ElTschonni/DROBOT-alpha/DROBOT-Client/G-Code/TestJe.txt

G1 X100 Y100 Z1 F1
G1 X8296 Y12619 Z1 F1
G1 X8296 Y16853 Z0 F1
G1 X9884 Y16853 Z0 F1
G1 X9884 Y17377 Z0 F1
G1 X6122 Y17377 Z0 F1
G1 X6122 Y16853 Z0 F1
G1 X7703 Y16853 Z0 F1
G1 X7703 Y12694 Z0 F1
G1 X10591 Y12619 Z1 F1
G1 X14131 Y12619 Z0 F1
G1 X14131 Y13144 Z0 F1
G1 X11184 Y13144 Z0 F1
G1 X11184 Y14820 Z0 F1
G1 X13840 Y14820 Z0 F1
G1 X13840 Y15341 Z0 F1
G1 X11184 Y15341 Z0 F1
G1 X11184 Y16853 Z0 F1
G1 X14020 Y16853 Z0 F1
G1 X14020 Y17377 Z0 F1
G1 X10666 Y17377 Z0 F1
G1 X15024 Y12619 Z1 F1
G1 X15618 Y12619 Z0 F1
G1 X15618 Y14271 Z0 F1
G1 X16427 Y15060 Z0 F1
G1 X18144 Y12619 Z0 F1
G1 X18930 Y12619 Z0 F1
G1 X16842 Y15456 Z0 F1
G1 X18831 Y17377 Z0 F1
G1 X18031 Y17377 Z0 F1
G1 X15618 Y14967 Z0 F1
G1 X15618 Y17377 Z0 F1
G1 X15024 Y17377 Z0 F1
G1 X15024 Y17372 Z0 F1
G1 X19986 Y15558 Z1 F1
G1 X19961 Y15350 Z0 F1
G1 X19943 Y14926 Z0 F1
G1 X19970 Y14550 Z0 F1
G1 X19998 Y14367 Z0 F1
G1 X20045 Y14189 Z0 F1
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
