ElTschonni/DROBOT-alpha/DROBOT-code/src/DR_v02_00.cpp

/*================================================================================
  o   ___          _   _         _   _             .
  -`^'-      o  <_*_>        '\\-//`       '\\-//`        ,-_-|
  (o o)      o  (o o)         (o o)         (o o)        ([o o])
  |--ooO--(_)--Ooo--8---(_)--Ooo-ooO--(_)--Ooo-ooO--(_)--Ooo-ooO--(_)--Ooo- --------|
  |Titel:         Delta Robot Project Teko 2022                                                     
  |File name:     DR_v02_00.cpp                                           
  |Autor Name:    Jonathan Ernst & Reto Bissig  
  |MechanicalTeam: Lorenz, Alain, 
  |Datum:         29.06.2022                                                        
  |Hardware:      M5Stack Core2 (Mikrocontroller: ESP32)                         
  |Software:      Platformio, VS Code                               
  |Beschreibung:  Delta Zeichnungsroboter 

  //Change Log 
2022-06-29_DROBOT_v00.002.ino  - Setup Modbus Server
2022-07-08_DROBOT_v00.007.ino  - I2C Library
2022-07-10_DROBOT_v00.010.cpp -- portation to platformio. - small changes to test I2C library, so far LED on.
2022-07-30_DROBOT_v01.000.cpp -- Setup drawing Random Lines
DR_v02_00.cpp -- Robot can receive new coordinates and draw percize lines

  |---------------------------------------------------------------------------------|
  //=========| include librarys |==================================================*/

#include "m5core2.h"
#include "DROBOT.h"  // Robot controll
#include "Wire.h"    // I2C

#include "WiFi.h"
#include "ModbusIP_ESP8266.h"
#include "WiFiMulti.h"
#include <Adafruit_MCP23X17.h>
#include <Adafruit_PWMServoDriver.h> //
#include "time.h"


//=========| definiere Werte |==================================================*/
#define ON HIGH
#define OFF LOW

#define UP HIGH
#define DOWN LOW

#define OPEN HIGH
#define CLOSE LOW


#define baudRate 2000000  //set baud rate for serial communiction

#define WLAN_SSID "L-TEKO"  // define: suchen und ersetzen im Code "L-TEKO", Wildbachhuis 2.4
#define WLAN_PASSWD "teko2016"     //"teko2016", Milkyway29!
#define MCP23017_ADDR 0x20            //I2C Addrese
#define I2C_Clock_Speed 1700000       // 1.7 MHz
IPAddress ClientIP(192, 168, 40, 68); 
#define Mright 1
#define Mleft 0

#define right_Arm 1
#define left_Arm 0

#define Mright_DIPSW_Value 0b0001  //initial Motor Speed in RPM
#define Mleft_DIPSW_Value 0b0001   //initial Motor Speed in RPM

//Robot Measurements:
#define CoordResolution *100

#define length_BaseToTip_Value 630 CoordResolution  // length from the rotation axis to the tool tip in mm
#define max_TimeForComand_value 60                  //maximum time for one command in s


#define Lenght_UpArm_Value 248 CoordResolution   //length of the  Upper Arm in mm
#define Lenght_LowArm_Value 336 CoordResolution  //length of the  Lower Arm in mm

#define MeetingPoint_TipPoint_Value 67 CoordResolution  //length between tip of the tool and meeting point of arms
#define MeetingPoint_TipPoint_AngleValue 98             //Angle of the line between Meetingpoint to tip of the tool
#define DeltaX_LeftArm_Value 254 CoordResolution        //Delta X from center to rotation point of the Left Arm
#define DeltaX_RightArm_Value 404 CoordResolution       //Delta X from center to rotation point of the Right Arm
#define Transmission_LeftArm_Value 2.5
#define Transmission_RightArm_Value 2.5

#define Coordinate_maxX_Value 600 CoordResolution
#define Coordinate_minX_Value 100 CoordResolution
#define Coordinate_maxY_Value 550 CoordResolution
#define Coordinate_minY_Value 200 CoordResolution

#define Coordinate_0X_Value 140 CoordResolution
#define Coordinate_0Y_Value 242 CoordResolution//-22mm offset 

#define DC_MotorTime_Value 8000  //ms DC Motor Time

//IOPorts //Adresses of Pins for Adafruit MCP23017
#define Mright_Pull_Pin 8     //	GPB0	MCP23017
#define Mright_Dir_Pin 9      //	GPB1	MCP23017
#define Mright_En_Pin 10      //	GPB2	MCP23017
#define Mright_Alarm_Pin 11   //	GPB3	MCP23017
#define Mright_Ped_Pin 12     //	GPB4	MCP23017
#define Limit_Switch_Pin 13   //	GPB5	MCP23017
#define Mvertical_ON_Pin 14   //	GPB6	MCP23017
#define Mvertical_DIR_Pin 15  //	GPB7	MCP23017
#define Clamp_Servo_Pin 0     //	GPA0	MCP23017
#define End_Button2_Pin 1     //	GPA1	MCP23017
#define End_Button1_Pin 2     //	GPA2	MCP23017
#define Mleft_Ped_Pin 3       //	GPA3	MCP23017
#define Mleft_Alarm_Pin 4     //	GPA4	MCP23017
#define Mleft_En_Pin 5        //	GPA5	MCP23017
#define Mleft_Dir_Pin 6       //	GPA6	MCP23017
#define Mleft_Pull_Pin 7      //	GPA7	MCP23017

//Define Servos Clamp
#define SERVOMIN  150 // This is the 'minimum' pulse length count (out of 4096)
#define SERVOMAX  600 // This is the 'maximum' pulse length count (out of 4096)
#define USMIN  600 // This is the rounded 'minimum' microsecond length based on the minimum pulse of 150
#define USMAX  2400 // This is the rounded 'maximum' microsecond length based on the maximum pulse of 600
#define SERVO_FREQ 50 // Analog servos run at ~50 Hz updates

//Sensors:

//Set Constants for modbus
// G01 X30.00 Y100.00 Z10.00 F100
const long BEFEHL_HREG = 0;  // Hreg 0 für den Befehl, z.B. G01
const long X_HREG = 1;       // Hreg 1 für die X-Koordinate
const long Y_HREG = 2;       // Hreg 2 für die Y-Koordinate
const long Z_HREG = 3;       // Hreg 3 für die Z-Koordinate
const long F_HREG = 4;       // Hreg 4 für die Geschwindigkeit
const long STATUS_HREG = 5;  // Hreg 5 für den Zustand der StateMachine


//=========| initializing Classes |==================================================*/
//ModbusIP object
ModbusIP mb;
WiFiMulti wiFiMulti;
Adafruit_MCP23X17 GPIO_Ports_Instanz;                         //creating the MCP23017 Instance
Closed_Loop_Step_Motor Motor_Left_Ins(&GPIO_Ports_Instanz);   //creating the Left Motor Instance
Closed_Loop_Step_Motor Motor_Right_Ins(&GPIO_Ports_Instanz);  //creating the Right Motor Instance
Motor_Movement_Calc MM_Calc_Ins;                              //create the motor movement calculation instance
Delta2D_Kinematic D2D_RightArm_Kin;                           //create the Kinematic Calculation instance
Delta2D_Kinematic D2D_LeftArm_Kin;                            //create the Kinematic Calculation instance
Adafruit_PWMServoDriver pwm_Ports_Instanz = Adafruit_PWMServoDriver(); // called this way, it uses the default address 0x40


//==============================================================================*/
//=========| deklaration von Variabeln |========================================*/
unsigned int programSelector = 6;  //Program selection variable

unsigned int StartUp = 1;
unsigned int LastState = 0;

bool Start_StateMachine = false;
unsigned int Status = 1;  // 1 ready
uint Befehl = 0;

//Timer Variabeln:

struct tm timeinfo;
const char* ntpServer = "0.ch.pool.ntp.org"; //0.ch.pool.ntp.org
const long  gmtOffset_sec = 3600;
const int   daylightOffset_sec = 3600;

unsigned long Timer_Start_01;
unsigned long Timer_Start_02;

unsigned long Timer_Interval_01 = 1000000;
unsigned long Timer_Interval_02 = 10000;

//ModBus

unsigned long X; //X Coordinates
unsigned long Y;
unsigned long Z;
unsigned long F;
unsigned long Alpha;
unsigned long Px, Xaktuell, Xneu;
unsigned long Py, Yaktuell, Yneu;


// Motor Variabeln
int Mright_Speed_Value = 1;  //initial Motor Speed in RPM
int Mleft_Speed_Value = 1;   //initial Motor Speed in RPM

//==============================================================================*/
//=========| Funktionen ModBus |=========================================*/

//Return new GCode_Command ReadModbusRegister CBneuerBefehl

//Return new Client_Command ReadModbusRegister CBneuerBefehl
uint16_t CBneuerBefehl(TRegister* reg, uint16_t val) {
  if (Start_StateMachine == false) {
    Serial.println("Neuer Befehl!");
    programSelector = 2;
    Befehl = mb.Hreg(BEFEHL_HREG);
    Start_StateMachine = true;
    LastState = 0;
  }
  return val;
}

uint16_t CBneuerParameterX(TRegister* reg, uint16_t val) {
  Serial.println("Neue Parameter X!");
  X = (mb.Hreg(X_HREG)) + (Coordinate_0X_Value);  // X in 100stel Millimeter
  LastState = 0;
  return val;
}
uint16_t CBneuerParameterY(TRegister* reg, uint16_t val) {
  Serial.println("Neue Parameter Y!");
  Y = (mb.Hreg(Y_HREG)) + (Coordinate_0Y_Value);
  LastState = 0;
  return val;
}
uint16_t CBneuerParameterZ(TRegister* reg, uint16_t val) {
  Serial.println("Neue Parameter Z!");
  Z = mb.Hreg(Z_HREG);

  LastState = 0;
  return val;
}
uint16_t CBneuerParameterF(TRegister* reg, uint16_t val) {
  Serial.println("Neue Parameter F!");
  F = mb.Hreg(F_HREG);  // Geschwindigkeit in mm/min
  LastState = 0;
  return val;
}



//=========| Funktionen Program |=========================================*/
void moveToNewPositionLeft() {
  unsigned long counterTollerance = 0;
  bool exitStep = false;

  do {
    //   Serial.print(" Number of Steps: ");
    //   Serial.print(counterTollerance++);

    do {  //do one step
      if (Motor_Left_Ins.OneStepDir() == 0) exitStep = false;
      else { exitStep = true; }
      if (Motor_Left_Ins.errorcode > 0) exitStep = true;
    } while (exitStep == false);

  } while (!Motor_Left_Ins.Angle_Tollerance_Value);

  counterTollerance = 0;
}

void moveToNewPositionRight() {
  unsigned long counterTollerance = 0;
  bool exitStep = false;

  do {
    //   Serial.print(" Number of Steps: ");
    //   Serial.print(counterTollerance++);

    do {  //do one step
      if (Motor_Right_Ins.OneStepDir() == 0) exitStep = false;
      else { exitStep = true; }
      if (Motor_Right_Ins.errorcode > 0) exitStep = true;
    } while (exitStep == false);

  } while (!Motor_Right_Ins.Angle_Tollerance_Value);

  counterTollerance = 0;
}

void moveToNewPosition() {
  unsigned long counterTollerance = 0;
  //unsigned long counter = 0;
  //double TotalTimeL = 0;
  // double TotalTimeR = 0;

  bool exitStep = false;


  do {
    //   Serial.print(" Number of Steps: ");
    counterTollerance++;
    /* Motor_Left_Ins.StartTimer();
  Motor_Right_Ins.StartTimer();*/

    do {  //do one step

      if (Motor_Right_Ins.OneStepDir() == 0) exitStep = false;
      else { exitStep = true; }
      if (Motor_Right_Ins.errorcode > 0) exitStep = true;

    } while (exitStep == false);
    do {  //do one step

      if (Motor_Left_Ins.OneStepDir() == 0) exitStep = false;
      else { exitStep = true; }
      if (Motor_Left_Ins.errorcode > 0) exitStep = true;
    } while (exitStep == false);
    /*counter++;
TotalTimeL= TotalTimeL + Motor_Left_Ins.TimeControll();*/
    //TotalTimeR= TotalTimeR + Motor_Right_Ins.TimeControll();


  } while (!Motor_Right_Ins.Angle_Tollerance_Value or !Motor_Left_Ins.Angle_Tollerance_Value);
  /*  Serial.println("");
  Serial.print("mTNP: Step Time L: ");
  Serial.println(TotalTimeL/counter);
  Serial.print(" R: ");
  Serial.println(TotalTimeR/counter);
  counter=0;*/

  Serial.println("mTNP: Both Angle in Tollerance: ");
  Motor_Left_Ins.setNewAngelValue(Motor_Left_Ins.getOldAngelValue());
  Motor_Right_Ins.setNewAngelValue(Motor_Right_Ins.getOldAngelValue());

  counterTollerance = 0;
}

//Z-Axis
bool controllZAxis(bool dir_DCMotor_val, unsigned long RunTime) {
  unsigned long startTime = 0;

  Serial.print("ZAX: End Button: ");
  Serial.println(GPIO_Ports_Instanz.digitalRead(Limit_Switch_Pin));

  if (dir_DCMotor_val and GPIO_Ports_Instanz.digitalRead(Limit_Switch_Pin))  //hoch
  {
  Serial.println("ZAX: UP: ");
  Serial.print("ZAX: Button: ");  
   Serial.println(GPIO_Ports_Instanz.digitalRead(Limit_Switch_Pin));
  Serial.print("ZAX: dir_DCMotor_val: ");
  Serial.println(dir_DCMotor_val);
  
    GPIO_Ports_Instanz.digitalWrite((Mvertical_DIR_Pin), HIGH);
    GPIO_Ports_Instanz.digitalWrite(Mvertical_ON_Pin, HIGH);

    do {  
    } while (GPIO_Ports_Instanz.digitalRead(Limit_Switch_Pin));
       GPIO_Ports_Instanz.digitalWrite(Mvertical_ON_Pin, LOW);

  } else if (!dir_DCMotor_val and !GPIO_Ports_Instanz.digitalRead(Limit_Switch_Pin))  //runter
  {
  Serial.println("ZAX: DOWN: ");
   Serial.print("ZAX: Button: ");  
   Serial.println(GPIO_Ports_Instanz.digitalRead(Limit_Switch_Pin));
  Serial.print("ZAX: dir_DCMotor_val: ");
  Serial.println(dir_DCMotor_val);

    GPIO_Ports_Instanz.digitalWrite((Mvertical_DIR_Pin), LOW);
    GPIO_Ports_Instanz.digitalWrite(Mvertical_ON_Pin, HIGH);  //Motor Ein
    startTime = millis();

    do {
    } while ((millis() - startTime < RunTime));
    GPIO_Ports_Instanz.digitalWrite(Mvertical_ON_Pin, LOW);  //Motor Aus
  } else {
    return (1);
  };

  return (1);
}


//Clamp
bool controllClamp(bool dir_clamp_value)//close: 0 open : 1
{uint16_t pulselength = 0;
  //close clamp
  if (!dir_clamp_value){
 for (pulselength = SERVOMIN; pulselength < SERVOMAX; pulselength++) {
    pwm_Ports_Instanz.setPWM(0, 0, pulselength);
    pwm_Ports_Instanz.setPWM(1, 0, pulselength);
    pwm_Ports_Instanz.setPWM(2, 0, pulselength);
  }
  pwm_Ports_Instanz.setPWM(0, 0, SERVOMAX);

}  //open clamp
  if (dir_clamp_value){
  for (pulselength = SERVOMAX; pulselength > SERVOMIN; pulselength--) {
    pwm_Ports_Instanz.setPWM(0, 0, pulselength);
    pwm_Ports_Instanz.setPWM(1, 0, pulselength);
    pwm_Ports_Instanz.setPWM(2, 0, pulselength);

   }
   pwm_Ports_Instanz.setPWM(0, 0, SERVOMIN);
   }
     return (1);
}

//Wifi Check
void checkWiFiConnection() { 
 

 if(!getLocalTime(&timeinfo)){
  Serial.println("Failed to obtain time");
     if (WiFi.status() == WL_CONNECTED) {
    }
    else{
    delay(350);
    Serial.println("Wifi Not Connected");
    WiFi.disconnect(); 

    wiFiMulti.addAP(WLAN_SSID, WLAN_PASSWD);
  long sum = 0;

  while (wiFiMulti.run() != WL_CONNECTED) {
    Serial.print(".");
    M5.lcd.print(".");
    sum += 1;
    if (sum == 8) {
      Serial.println("!Connect: Failed!");
      M5.lcd.print("!Connect: Failed!");
      wiFiMulti.addAP(WLAN_SSID, WLAN_PASSWD);
    }
  }
}
  }
  
  
}

//=========| Funktionen StateMachine |=========================================*/



unsigned int Standby()  //State 1
{
       
  //mb.Hreg(STATUS_HREG, Status);
  //  mb.Hreg(STATUS_HREG, 4);

 delay(1000);
  M5.Lcd.fillRect(10,40,240,20,GREEN);
    M5.Lcd.setCursor(10, 40);
   getLocalTime(&timeinfo);
    M5.lcd.print(&timeinfo);
 delay(1000);
  M5.Lcd.fillRect(10,40,240,20,GREEN);
    M5.Lcd.setCursor(10, 40);
   getLocalTime(&timeinfo);
    M5.lcd.print(&timeinfo);

  if (LastState != 1) {//set Robot Status to 1 and send this info to client
    Status = 1;
    mb.Hreg(STATUS_HREG, Status);

    Start_StateMachine = false;
    M5.Lcd.fillScreen(GREEN);
  M5.Lcd.setTextSize(3);
  M5.Lcd.setCursor(10, 10);
  M5.Lcd.setTextColor(BLACK);

    Serial.print("- Standby: ");
    M5.lcd.println("Standby");
    M5.Lcd.setCursor(10, 60);
      M5.Lcd.setTextColor(NAVY);
       M5.Lcd.setTextSize(2);
  Serial.print("IP: ");
  Serial.println(WiFi.localIP());
 M5.Lcd.print("IP: ");
 M5.Lcd.println(WiFi.localIP());

    //programSelector = 1;

    Serial.print(STATUS_HREG);
    Serial.print(Status);
    Serial.print("- Roboter_State: ");
    Serial.print(Status);
    Serial.print(" GCode_Command: ");
    Serial.print(Befehl);
    Serial.print(" Start Statemachine: ");
    Serial.println(Start_StateMachine);
  }

  //GPIO_Ports_Instanz.digitalWrite(Clamp_Servo_Pin, HIGH);
     M5.Lcd.setTextColor(NAVY);
     M5.Lcd.fillRect(6,210,100,30,DARKGREEN);
     M5.Lcd.setCursor(16,220);
    M5.Lcd.print("CLOSE");

M5.Lcd.fillRect(109,210,100,30,DARKGREEN);
    M5.Lcd.setCursor(119, 220);
    M5.Lcd.print("OPEN");

M5.Lcd.fillRect(212,210,100,30,DARKGREEN);
    M5.Lcd.setCursor(225, 220);
    M5.Lcd.print("HOME");

 if (M5.BtnA.wasReleased() || M5.BtnA.pressedFor(1000, 200)) {
       M5.Lcd.setTextColor(NAVY);
     M5.Lcd.fillRect(6,210,100,30,GREENYELLOW);
     M5.Lcd.setCursor(16,220);
    M5.Lcd.print("CLOSING");
   Serial.println(" S1: Closing Clamp ");
      controllClamp(CLOSE);
      delay(1000);

  } else if (M5.BtnB.wasReleased() || M5.BtnB.pressedFor(1000, 200)) {
     M5.Lcd.fillRect(109,210,100,30,GREENYELLOW);
    M5.Lcd.setCursor(119, 220);
    M5.Lcd.print("OPENING");
   Serial.println(" S1: OPENING Clamp ");
      controllClamp(OPEN);
            delay(1000);

  } else if (M5.BtnC.wasReleased() || M5.BtnC.pressedFor(1000, 200)) {
M5.Lcd.fillRect(212,210,100,30,DARKGREEN);
    M5.Lcd.setCursor(225, 220);
    M5.Lcd.print("HOMING");
   Serial.println(" S1: homing ");
   programSelector =7;

    delay(1000);
  }   
      
  LastState = 1;
  return (programSelector);
}

unsigned int Receive()  //State 2 Verarbeitung
{M5.Lcd.fillScreen(GREENYELLOW);
  Serial.println("------ State Receive------");
  Serial.print("- Roboter_State: ");
  Serial.println(Status);
  Serial.print("- GCode_Command: ");
  Serial.println(Befehl);
  Serial.print("- Start Statemachine: ");
  Serial.println(Start_StateMachine);


  if (Status == 1 and Start_StateMachine) {
    Serial.println("- StateMachine: Started");

    if (Befehl == 0 or Befehl == 1) {
      Serial.println("- Receive: Data");
      Serial.print(" G");
      Serial.print(Befehl);
      Serial.print(" X");
      Serial.print(X);
      Serial.print(" Y");
      Serial.print(Y);
      Serial.print(" Z");
      Serial.print(Z);
      Serial.print(" F");
      Serial.println(F);

      MM_Calc_Ins.setTargetCoordinates(X, Y);

      MM_Calc_Ins.Done_Steps_Value = 0;
 LastState = 2;
      Status = 2;  // gehe zu draw

        M5.Lcd.fillScreen(NAVY);
      return (3);

      /*

      if(X>(Coordinate_maxX_Value)){
           Serial.println("Warning: X Coordinates above <Radius of Action>");
      Status = 3;  // gehe zu draw
      return (5);
      }
      if(X<(Coordinate_minX_Value)){
         Serial.println("Warning: X Coordinates below <Radius of Action>");
      Status = 3;  // gehe zu draw
      return (5);
      }
            if(Y>(Coordinate_maxY_Value)){
               Serial.println("Warning: Y Coordinates above <Radius of Action>");
      Status = 3;  // gehe zu draw
      return (5);
      }
            if(Y<(Coordinate_minY_Value)){
               Serial.println("Warning: Y Coordinates below <Radius of Action>");
      Status = 3;  // gehe zu draw
      return (5);
      }

*/

    } else {
      Status = 3;  // falscher Befehl
       LastState = 2;
      return (4);
    }
  }

  /*
  if (Timer_Start_01 + Timer_Interval_01 < micros()) {
    Timer_Start_01 = micros();
    Timer_Interval_01 = 1000000;
  }*/
 
}

unsigned int Draw() {  //State 3
Status = 2;
  mb.Hreg(STATUS_HREG, Status);
   mb.Hreg(STATUS_HREG, Status);


    Serial.println("S3: Draw");
     Serial.print("S3: Roboter Status: ");
      Serial.print(Status);

    M5.Lcd.setTextSize(3);
  M5.Lcd.setCursor(10, 10);
  M5.Lcd.setTextColor(ORANGE);
  M5.lcd.println("DRAW");
  M5.Lcd.setTextSize(2);
  M5.Lcd.fillRect(10,40,240,20,NAVY);
    M5.Lcd.setCursor(10,40);

   getLocalTime(&timeinfo);
      M5.lcd.print(&timeinfo);

        M5.Lcd.fillRect(10,60,280,20,NAVY);
  M5.Lcd.setCursor(10, 60);
  M5.Lcd.setTextColor(GREENYELLOW);
    M5.lcd.print("o>X "); 
    M5.Lcd.setTextColor(YELLOW);
    M5.Lcd.drawFloat(MM_Calc_Ins.X1_Origin_Value, 0, 50, 60);
     // M5.lcd.print(MM_Calc_Ins.Xz_NextStep_Value);
       M5.Lcd.setCursor(150, 60);
      M5.Lcd.setTextColor(GREENYELLOW);
        M5.lcd.print("o>TY ");
        M5.Lcd.setTextColor(YELLOW);
        M5.Lcd.drawFloat(MM_Calc_Ins.Y1_Origin_Value, 0, 200,60);
        //  M5.lcd.println(MM_Calc_Ins.Yz_NextStep_Value);
  
  M5.Lcd.fillRect(10,80,280,20,NAVY);
  M5.Lcd.setCursor(10, 80);
  M5.Lcd.setTextColor(GREENYELLOW);
    M5.lcd.print("o X "); 
    M5.Lcd.setTextColor(YELLOW);
    M5.Lcd.drawFloat(MM_Calc_Ins.Xz_NextStep_Value, 0, 50,80);
     // M5.lcd.print(MM_Calc_Ins.Xz_NextStep_Value);
       M5.Lcd.setCursor(150, 80);
      M5.Lcd.setTextColor(GREENYELLOW);
        M5.lcd.print("o Y ");
        M5.Lcd.setTextColor(YELLOW);
        M5.Lcd.drawFloat(MM_Calc_Ins.Yz_NextStep_Value, 0, 200,80);
        //  M5.lcd.println(MM_Calc_Ins.Yz_NextStep_Value);

  M5.Lcd.fillRect(10,100,280,20,NAVY);
  M5.Lcd.setCursor(10, 100);
  M5.Lcd.setTextColor(GREENYELLOW);
    M5.lcd.print(">oX "); 
    M5.Lcd.setTextColor(YELLOW);
    M5.Lcd.drawFloat(MM_Calc_Ins.X2_Target_Value, 0, 50, 100);
     // M5.lcd.print(MM_Calc_Ins.Xz_NextStep_Value);
       M5.Lcd.setCursor(150, 100);
      M5.Lcd.setTextColor(GREENYELLOW);
        M5.lcd.print(">oTY ");
        M5.Lcd.setTextColor(YELLOW);
        M5.Lcd.drawFloat(MM_Calc_Ins.Y2_Target_Value, 0, 200,100);
        //  M5.lcd.println(MM_Calc_Ins.Yz_NextStep_Value);
    
    M5.Lcd.fillRect(10,120,240,20,NAVY);
   M5.Lcd.setCursor(10, 120);
  M5.Lcd.setTextColor(GREENYELLOW);
    M5.lcd.print("alphaL: "); 
    M5.Lcd.setTextColor(YELLOW);
       M5.Lcd.drawFloat(Motor_Left_Ins.getNewAngelValue(), 2, 100,120);
     // M5.lcd.println(Motor_Left_Ins.getNewAngelValue());
     
    M5.Lcd.fillRect(10,140,240,20,NAVY);
     M5.Lcd.setCursor(10, 140);
          M5.Lcd.setTextColor(GREENYELLOW);
        M5.lcd.print("alphaR: ");
        M5.Lcd.setTextColor(YELLOW);
          M5.Lcd.drawFloat(Motor_Right_Ins.getNewAngelValue(), 2, 100,140);
        //  M5.lcd.println(Motor_Right_Ins.getNewAngelValue());
    M5.Lcd.fillRect(10,160,240,20,NAVY);
     M5.Lcd.setCursor(10,160);
  M5.Lcd.setTextColor(GREENYELLOW);
    M5.lcd.print("Progress: "); M5.Lcd.setTextColor(YELLOW);
  M5.Lcd.drawFloat((MM_Calc_Ins.Done_Steps_Value*1.00/(MM_Calc_Ins.TotalNof_Steps_Value*1.00+1.00))*100.00, 2, 120,160);
     // M5.lcd.print((MM_Calc_Ins.Done_Steps_Value*1.00/(MM_Calc_Ins.TotalNof_Steps_Value*1.00+1.00))*100.00 );
      M5.Lcd.setTextColor(GREENYELLOW);
       M5.Lcd.setCursor(200, 160);
        M5.lcd.println("% ");M5.Lcd.setTextColor(YELLOW);

  double old_Angle_value = 0;
  double new_Angle_value = 0;
  unsigned long determinant_RightArm_Value = 0;
  unsigned long determinant_LeftArm_Value = 0;


if (Z>0){
  Serial.print(" S3: DC Motor Up: ");

  do { } while (!controllZAxis(UP, DC_MotorTime_Value));
}
if (Z==0){
  Serial.print(" S3: DC Motor Down: ");

  do { } while (!controllZAxis(DOWN, DC_MotorTime_Value));
}


  //delay(500);
  //1.Step: LED Blink,
  //Motor_Left_Ins.test();  //Motor Class Test

  //2.Step:  set new target coordinates and start the interpolation:

  MM_Calc_Ins.Interpolate();

  //3.Step: Calculate new Angle to reach thos coordinates.
  //Right arm first //Calculation with Tool Offset
  determinant_RightArm_Value = D2D_RightArm_Kin.IntersectionOfTwoCircles(DeltaX_RightArm_Value, 0, MM_Calc_Ins.Xz_NextStep_Value, MM_Calc_Ins.Yz_NextStep_Value);
  if (determinant_RightArm_Value == 2) {
    D2D_RightArm_Kin.InverseKinematic(right_Arm);
  }

  else {
    Serial.print("S3: Kinematic Error Right:  ");
    Serial.println(determinant_RightArm_Value);
  }

//calculate coordinates for the second arm Left
D2D_RightArm_Kin.RecalcCoordinates(MM_Calc_Ins.Xz_NextStep_Value,MM_Calc_Ins.Yz_NextStep_Value);


  //Left Arm
  determinant_LeftArm_Value = D2D_LeftArm_Kin.IntersectionOfTwoCircles(DeltaX_LeftArm_Value, 0, D2D_RightArm_Kin.Xz_newRightArm_Value, D2D_RightArm_Kin.Yz_newRightArm_Value);
  if (determinant_LeftArm_Value == 2) {
    D2D_LeftArm_Kin.InverseKinematic(left_Arm);
  }

  else {
    Serial.print("S3: Kinematic Error Left:  ");
    Serial.println(determinant_LeftArm_Value);
  }

//Step 3.1 Calculate other coordinates

  //4.Step:  set new angle

  if (Motor_Left_Ins.setNewAngelValue(D2D_LeftArm_Kin.angle_LeftArm_Value2)) Serial.println("S3:  Motor Left Set Angle: Succeed");
  else {
    Serial.println("S3: Motor Left Set Angle: Failed");
    return (5);
  }

  if (Motor_Right_Ins.setNewAngelValue(D2D_RightArm_Kin.angle_RightArm_Value1)) Serial.println("S3:  Motor Right Set Angle: Succeed");
  else {
    Serial.println("S3: Motor Right Set Angle: Failed");
    return (5);
  }

  //5.Step: move from old angle to new angle
  /*
moveToNewPositionLeft();
moveToNewPositionRight();
*/
  moveToNewPosition();

  //6.Step: exit conditions:
  Start_StateMachine = false;

  //delay(3000);
  //7.Step: if there was an error, go to State 3 Error
  if (Motor_Left_Ins.errorcode > 0) {
    //Status = 3;
    return (5);
  }
  //8.Step: if the current coordinates are not equal to the target coordinates do the loop again
  else if ((MM_Calc_Ins.Xz_NextStep_Value < MM_Calc_Ins.X2_Target_Value) and (MM_Calc_Ins.Yz_NextStep_Value < MM_Calc_Ins.Y2_Target_Value)) {


    if ((MM_Calc_Ins.Xz_NextStep_Value == 0) or (MM_Calc_Ins.Yz_NextStep_Value == 0)) {
     // Status = 3;
      LastState = 3;
      return (5);
    } else {
      //Status = 2;
      LastState = 3;
      return (3);
    }

  } else if ((MM_Calc_Ins.Xz_NextStep_Value == MM_Calc_Ins.X2_Target_Value) and (MM_Calc_Ins.Yz_NextStep_Value == MM_Calc_Ins.Y2_Target_Value)) {
    //9.Step: if the Target Coordinates are equal to the current coordinates, go to state 1
    Serial.print("S3: New Coordinates have been reached: Xz ");
    Serial.print(MM_Calc_Ins.Xz_NextStep_Value);
    Serial.print("Yz ");
    Serial.print(MM_Calc_Ins.Yz_NextStep_Value);
    Serial.print(" / X2 ");
    Serial.print(MM_Calc_Ins.X2_Target_Value);
    Serial.print(" / Y2 ");
    Serial.println(MM_Calc_Ins.Y2_Target_Value);
    Serial.print("S3:  Waiting for new Coordinates ");

    MM_Calc_Ins.setOriginCoordinates(MM_Calc_Ins.X2_Target_Value, MM_Calc_Ins.Y2_Target_Value);

  
    LastState = 3;
    return (1);
  } else {

    if (MM_Calc_Ins.Done_Steps_Value < MM_Calc_Ins.TotalNof_Steps_Value) {

      Serial.print("S3: Coordinates and Angle Match -> go to next Interpolate Step. ");


      LastState = 3;
      return (3);
    } else if (MM_Calc_Ins.Done_Steps_Value == MM_Calc_Ins.TotalNof_Steps_Value) { //Ziel Koordinaten wurden erreicht

      Serial.print("S3: Interpolate Steps Finished: Xz ");
      Serial.print(MM_Calc_Ins.Xz_NextStep_Value);
      Serial.print("Yz ");
      Serial.print(MM_Calc_Ins.Yz_NextStep_Value);
      Serial.print(" / X2 ");
      Serial.print(MM_Calc_Ins.X2_Target_Value);
      Serial.print(" / Y2 ");
      Serial.println(MM_Calc_Ins.Y2_Target_Value);
      Serial.print("S3:  Waiting for new Coordinates ");

      MM_Calc_Ins.setOriginCoordinates(MM_Calc_Ins.X2_Target_Value, MM_Calc_Ins.Y2_Target_Value);


      LastState = 3;
      return (1);
    } else {
      Serial.println("S3: Error Case ");  //error case print data

      Serial.print("S3: Origin:   X1: ");
      Serial.print(MM_Calc_Ins.X1_Origin_Value);
      Serial.print(" Y1: ");
      Serial.println(MM_Calc_Ins.Y1_Origin_Value);

      Serial.print("S3: NextStep: Xz: ");
      Serial.print(MM_Calc_Ins.Xz_NextStep_Value);
      Serial.print(" Yz: ");
      Serial.println(MM_Calc_Ins.Yz_NextStep_Value);

      Serial.print("S3: Target:    X2: ");
      Serial.print(MM_Calc_Ins.X2_Target_Value);
      Serial.print(" Y2: ");
      Serial.println(MM_Calc_Ins.Y2_Target_Value);

      Serial.print("S3: OldAngle: L°: ");
      Serial.print(Motor_Left_Ins.getOldAngelValue());
      Serial.print(" R°: ");
      Serial.println(Motor_Right_Ins.getOldAngelValue());

      Serial.print("S3: NewAngle: L°: ");
      Serial.print(Motor_Left_Ins.getNewAngelValue());
      Serial.print(" R°: ");
      Serial.println(Motor_Right_Ins.getNewAngelValue());

      Serial.print("S3: MinResol:  L: ");
      Serial.print(MM_Calc_Ins.Min_Resolution_Value);
      Serial.print(" Max°: ");
      Serial.print(Motor_Left_Ins.Max_AngDev_Value);
      Serial.print(" Min°: ");
      Serial.println(Motor_Left_Ins.Min_AngDev_Value);

      Serial.print("S3: MinResol:  R: ");
      Serial.print(MM_Calc_Ins.Min_Resolution_Value);
      Serial.print(" Max°: ");
      Serial.print(Motor_Right_Ins.Max_AngDev_Value);
      Serial.print(" Min°: ");
      Serial.println(Motor_Right_Ins.Min_AngDev_Value);

      Serial.print("S3: L°: ");
      Serial.print(Motor_Left_Ins.getNewAngelValue());
      Serial.print(" R°: ");
      Serial.println(Motor_Right_Ins.getNewAngelValue());

      LastState = 3;

      return (5);
    }
  }
}

unsigned int WrongCommand()  //State 4, steuert die Motoren
{M5.Lcd.fillScreen(REPEAT_DELAY);
  Serial.println("------ Wrong Command -------");
    Status = 3;
   mb.Hreg(STATUS_HREG, Status);

  return (1);
  LastState = 4;
}

unsigned int Error() {  //State 5
M5.Lcd.fillScreen(RED);
  Serial.println("------ Error -------");
  Serial.print(" Error Code Motor Left: ");
  Serial.println(Motor_Left_Ins.errorcode);
  Serial.print(" Error Code Motor Right: ");
  Serial.println(Motor_Right_Ins.errorcode);
    Status = 3;
   mb.Hreg(STATUS_HREG, Status);

  Motor_Left_Ins.errorcode = 0;
  Motor_Right_Ins.errorcode = 0;


  return (1);
  LastState = 5;
}


unsigned int Init() {  // State 6
  Serial.println("------ Initialize -------");
  M5.Lcd.fillScreen(ORANGE);
  M5.Lcd.setTextSize(5);
  M5.Lcd.setCursor(10, 10);
  M5.Lcd.setTextColor(BLACK);
  M5.lcd.println("------ Initialize -------");
  //Initialize Motor Left
  Serial.println("Init: Motor Left");
  M5.Lcd.setTextSize(3);
    M5.Lcd.setCursor(10, 20);
  M5.lcd.println("Init: Motor Left");

  Motor_Left_Ins.setupMotor(
    Mleft,
    Mleft_En_Pin,
    Mleft_Pull_Pin,
    Mleft_Dir_Pin,
    Mleft_Alarm_Pin,
    Mleft_Ped_Pin,
    Mleft_Speed_Value,
    Mleft_DIPSW_Value,
    Transmission_LeftArm_Value);

  Serial.print(" Mleft: ");
  M5.lcd.print(" Mleft: ");

  Serial.print(" RPM: ");
  M5.lcd.print(" RPM: ");
  Serial.println(Mleft_Speed_Value);
  M5.lcd.println(Mleft_Speed_Value);

  Serial.print(" DIPSW: ");
  M5.lcd.print(" DIPSW: ");
  Serial.println(Mleft_DIPSW_Value);
  M5.lcd.println(Mleft_DIPSW_Value);

  Serial.print(" MStepsPRev: ");
  M5.lcd.print(" MStepsPRev: ");
  Serial.println(Motor_Left_Ins.Steps_Per_rev);
  M5.lcd.println(Motor_Left_Ins.Steps_Per_rev);


  Serial.print(" MAngle: ");
  M5.lcd.print(" MAngle: ");
  Serial.println(Motor_Left_Ins.Motor_Angle_Value);
  M5.lcd.println(Motor_Left_Ins.Motor_Angle_Value);

  Serial.print(" MAnglePS: ");
  M5.lcd.print(" MAnglePS: ");
  Serial.println(Motor_Left_Ins.Angle_Per_step);
  M5.lcd.println(Motor_Left_Ins.Angle_Per_step);


  Serial.print(" MRPM SP: ");
  M5.lcd.print(" MRPM SP: ");
  Serial.println(Motor_Left_Ins.RPM_SetPoint_Value);
  M5.lcd.println(Motor_Left_Ins.RPM_SetPoint_Value);

  Serial.print(" MRPM PV: ");
  M5.lcd.print(" MRPM PV: ");
  Serial.println(Motor_Left_Ins.RPM_ProcessVariable_Value);
  M5.lcd.println(Motor_Left_Ins.RPM_ProcessVariable_Value);

  Serial.print(" MRPM EV: ");
  M5.lcd.print(" MRPM EV: ");
  Serial.println(Motor_Left_Ins.RPM_Error_Value);
  M5.lcd.println(Motor_Left_Ins.RPM_Error_Value);


  Serial.print(" MTPR: ");
  M5.lcd.print(" MTPR: ");
  Serial.println(Motor_Left_Ins.Time_PerRotation_Value);
  M5.lcd.println(Motor_Left_Ins.Time_PerRotation_Value);


  Serial.print(" MTPS: ");
  M5.lcd.print(" MTPS: ");
  Serial.println(Motor_Left_Ins.Time_PerStep_Value);
  M5.lcd.println(Motor_Left_Ins.Time_PerStep_Value);

  Serial.print(" MFtreq: ");
  M5.lcd.print(" MFtreq: ");
  Serial.println(Motor_Left_Ins.Frequency_Pulse_Value);
  M5.lcd.println(Motor_Left_Ins.Frequency_Pulse_Value);

  Serial.print(" MFtreqI2C: ");
  M5.lcd.print(" MFtreqI2C: ");
  Serial.println(Motor_Left_Ins.Frequency_I2CBus_Value);
  M5.lcd.println(Motor_Left_Ins.Frequency_I2CBus_Value);

  Serial.println("Init: Motor Left Succeed");
  M5.lcd.println("Init: Motor Left Succeed");

  Serial.print("PEDL: ");
  Serial.println(GPIO_Ports_Instanz.digitalRead(Mleft_Ped_Pin));
  Serial.print("ALML: ");
  Serial.println(GPIO_Ports_Instanz.digitalRead(Mleft_Alarm_Pin));


  //Initialize Motor Right
  Serial.println("Init: Motor Right");
    M5.Lcd.setTextSize(3);
    M5.Lcd.setCursor(10, 20);
  M5.lcd.println("Init: Motor Right");

  Motor_Right_Ins.setupMotor(
    Mright,
    Mright_En_Pin,
    Mright_Pull_Pin,
    Mright_Dir_Pin,
    Mright_Alarm_Pin,
    Mright_Ped_Pin,
    Mright_Speed_Value,
    Mright_DIPSW_Value,
    Transmission_RightArm_Value);

  Serial.print(" Mright: ");
  M5.lcd.print(" Mright: ");

  Serial.print(" RPM: ");
  M5.lcd.print(" RPM: ");
  Serial.println(Mright_Speed_Value);
  M5.lcd.println(Mright_Speed_Value);

  Serial.print(" DIPSW: ");
  M5.lcd.print(" DIPSW: ");
  Serial.println(Mright_DIPSW_Value);
  M5.lcd.println(Mright_DIPSW_Value);

  Serial.print(" MStepsPRev: ");
  M5.lcd.print(" MStepsPRev: ");
  Serial.println(Motor_Right_Ins.Steps_Per_rev);
  M5.lcd.println(Motor_Right_Ins.Steps_Per_rev);


  Serial.print(" MAngle: ");
  M5.lcd.print(" MAngle: ");
  Serial.println(Motor_Right_Ins.Motor_Angle_Value);
  M5.lcd.println(Motor_Right_Ins.Motor_Angle_Value);

  Serial.print(" MAnglePS: ");
  M5.lcd.print(" MAnglePS: ");
  Serial.println(Motor_Right_Ins.Angle_Per_step);
  M5.lcd.println(Motor_Right_Ins.Angle_Per_step);


  Serial.print(" MRPM SP: ");
  M5.lcd.print(" MRPM SP: ");
  Serial.println(Motor_Right_Ins.RPM_SetPoint_Value);
  M5.lcd.println(Motor_Right_Ins.RPM_SetPoint_Value);

  Serial.print(" MRPM PV: ");
  M5.lcd.print(" MRPM PV: ");
  Serial.println(Motor_Right_Ins.RPM_ProcessVariable_Value);
  M5.lcd.println(Motor_Right_Ins.RPM_ProcessVariable_Value);

  Serial.print(" MRPM EV: ");
  M5.lcd.print(" MRPM EV: ");
  Serial.println(Motor_Right_Ins.RPM_Error_Value);
  M5.lcd.println(Motor_Right_Ins.RPM_Error_Value);


  Serial.print(" MTPR: ");
  M5.lcd.print(" MTPR: ");
  Serial.println(Motor_Right_Ins.Time_PerRotation_Value);
  M5.lcd.println(Motor_Right_Ins.Time_PerRotation_Value);


  Serial.print(" MTPS: ");
  M5.lcd.print(" MTPS: ");
  Serial.println(Motor_Right_Ins.Time_PerStep_Value);
  M5.lcd.println(Motor_Right_Ins.Time_PerStep_Value);

  Serial.print(" MFtreq: ");
  M5.lcd.print(" MFtreq: ");
  Serial.println(Motor_Right_Ins.Frequency_Pulse_Value);
  M5.lcd.println(Motor_Right_Ins.Frequency_Pulse_Value);

  Serial.print(" MFtreqI2C: ");
  M5.lcd.print(" MFtreqI2C: ");
  Serial.println(Motor_Right_Ins.Frequency_I2CBus_Value);
  M5.lcd.println(Motor_Right_Ins.Frequency_I2CBus_Value);


  Serial.println("Init: Motor Right Succeed");
  M5.lcd.println("Init: Motor Right Succeed");

  //init calculation class
    M5.Lcd.setTextSize(3);
    M5.Lcd.setCursor(10, 20);
  Serial.println("Init: Calculation");
  M5.lcd.println("Init: Calculation");

  MM_Calc_Ins.setupInterpolate(Motor_Left_Ins.Steps_Per_rev, Motor_Left_Ins.Angle_Per_step, length_BaseToTip_Value);
  MM_Calc_Ins.setMaxTime(max_TimeForComand_value);
  MM_Calc_Ins.setDoneSteps(0);


  D2D_RightArm_Kin.setupDelta2D_Kinematic(
    Lenght_UpArm_Value, Lenght_LowArm_Value,
    right_Arm, MeetingPoint_TipPoint_Value, MeetingPoint_TipPoint_AngleValue,
    DeltaX_LeftArm_Value, DeltaX_RightArm_Value,
    Transmission_LeftArm_Value, Transmission_RightArm_Value);

  D2D_LeftArm_Kin.setupDelta2D_Kinematic(
    Lenght_UpArm_Value, Lenght_LowArm_Value,
    left_Arm,MeetingPoint_TipPoint_Value, MeetingPoint_TipPoint_AngleValue,
    DeltaX_LeftArm_Value, DeltaX_RightArm_Value,
    Transmission_LeftArm_Value, Transmission_RightArm_Value);

//Setup UIX

  M5.Lcd.setTextSize(3);
    M5.Lcd.setCursor(10, 20);
  Serial.println("Init: Calculation Succeed");
  M5.lcd.println("Init: Calculation Succeed");



    LastState = 7;
  return (7);

}

unsigned int Calibrate() {  //State 7
  unsigned int counterLeft = 10;
  unsigned int counterRight = 0;
  unsigned int counter = Motor_Left_Ins.Steps_Per_rev / 8;
bool stateControlZAxisDown;
  M5.Lcd.fillScreen(YELLOW);
  M5.Lcd.setTextSize(3);
  M5.Lcd.setCursor(10, 10);
  M5.Lcd.setTextColor(BLACK);
  M5.lcd.println("Calibration");
  Serial.println("------ Calibration -------");
  M5.Lcd.setTextSize(2);
  M5.Lcd.setCursor(10, 50);
  M5.Lcd.setTextColor(BLUE);

//Close Clamp

 Serial.println(" CAL: Close Clamp ");
/*
  for (uint16_t pulselength = SERVOMIN; pulselength < SERVOMAX; pulselength++) {
    pwm_Ports_Instanz.setPWM(0, 0, pulselength);
  }*/

//Open Clamp
  delay(500);

   Serial.println(" CAL: Open Clamp ");
   controllClamp(OPEN);
/*
  for (uint16_t pulselength = SERVOMAX; pulselength > SERVOMIN; pulselength--) {
    pwm_Ports_Instanz.setPWM(0, 0, pulselength);
  }*/

  delay(500);




  Serial.print(" CAL: DC Motor Down: ");
  M5.lcd.println("CAL: Z Axis");
  do { /*Serial.print(".");*/
  stateControlZAxisDown=controllZAxis(DOWN, DC_MotorTime_Value);
  Serial.print("stateControlZAxisDown: ");
  Serial.println(stateControlZAxisDown);
  
   } while (stateControlZAxisDown == 0);
  Serial.println("");


  //Z-Axis UP
  Serial.print(" CAL: DC Motor Up: ");

  do { Serial.print("^"); } while (!controllZAxis(UP, DC_MotorTime_Value));
  Serial.println("");

  //1. move Motor left to endpoint 1
    
  Serial.print(" CAL: Motor Left to endpoint 1: ");
  Serial.print(GPIO_Ports_Instanz.digitalRead(End_Button2_Pin));

  do {

    do {
      Motor_Left_Ins.moveOneStep(Motor_Turn_left);
      counterLeft++;
    } while ((counterLeft < counter) and GPIO_Ports_Instanz.digitalRead(End_Button2_Pin));

    do {
      Motor_Left_Ins.moveOneStep(Motor_Turn_right);
      counterRight++;
    } while ((counterRight < (counter + 1)) and GPIO_Ports_Instanz.digitalRead(End_Button2_Pin));

    counterRight = 0;
    counter = counter + 2;

  } while ((GPIO_Ports_Instanz.digitalRead(End_Button2_Pin)));
  Serial.println(GPIO_Ports_Instanz.digitalRead(End_Button2_Pin));
M5.lcd.println("CAL: Motor Left at 90°");

  //2.save Angle of Motor left

  if (Motor_Left_Ins.setOldAngelValue(90)) Serial.println("Motor Left Set Angle: Succeed");
  else {
    Serial.println("Motor Left Set Angle: Failed");
    return (5);
  }

  //3. move Motor left to position 180°
      
  if (Motor_Left_Ins.setNewAngelValue(180)) Serial.println("Motor Left Set Angle: Succeed");
  else {
    Serial.println("Motor Left Set Angle: Failed");
    return (5);
  }

  moveToNewPositionLeft();

  if (Motor_Left_Ins.setOldAngelValue(180)) Serial.println("Motor Left Set Angle: Succeed");
  else {
    Serial.println("Motor Left Set Angle: Failed");
    return (5);
  }
M5.lcd.println("CAL: Motor Left at 180°");
  //4. move Motor right to enpoint 2
  counter = Motor_Left_Ins.Steps_Per_rev / 4;

  Serial.print(" CAL: Motor Right to endpoint 2: ");
  Serial.print(GPIO_Ports_Instanz.digitalRead(End_Button1_Pin));
  Serial.print(GPIO_Ports_Instanz.digitalRead(Mright_Ped_Pin));

  do {

    do {
      Motor_Right_Ins.moveOneStep(Motor_Turn_left);
      counterLeft++;
    } while ((counterLeft < counter) and GPIO_Ports_Instanz.digitalRead(End_Button1_Pin));

    do {
      Motor_Right_Ins.moveOneStep(Motor_Turn_right);
      counterRight++;
    } while ((counterRight < (counter + 5)) and GPIO_Ports_Instanz.digitalRead(End_Button1_Pin));
    counterLeft = 0;
    //counterRight = 0;
    counter = counter + Motor_Left_Ins.Steps_Per_rev / 8;

  } while ((GPIO_Ports_Instanz.digitalRead(End_Button1_Pin)));
  Serial.println(GPIO_Ports_Instanz.digitalRead(End_Button1_Pin));


  //5. save position of Motor Right
    M5.lcd.println("CAL: Motor Right set Angle 90°");

  if (Motor_Right_Ins.setOldAngelValue(90)) Serial.println("Motor Right Set Angle: Succeed");
  else {
    Serial.println("Motor Right Set Angle: Failed");
    return (5);
  }

  M5.lcd.println("CAL: Motor Right at 90°");

  //6. move to position 0/0
  MM_Calc_Ins.setTargetCoordinates(Coordinate_0X_Value, Coordinate_0Y_Value);

  //inverse Kinematic

  //set origin Coordinates to x0/y0
  MM_Calc_Ins.setOriginCoordinates(8000, 31000);


  Serial.print(" Calibration: New Coordinates: X: ");
  Serial.print(MM_Calc_Ins.X1_Origin_Value);
  Serial.print(" Y: ");
  Serial.println(MM_Calc_Ins.Y1_Origin_Value);

  Serial.print(" Calibration: Successfull ");
  Serial.println(Motor_Right_Ins.errorcode);
    M5.lcd.println("Calibration: Successfull");

  Status = 1;
  LastState = 8;
  return (1);
}



//=========| MAIN |=============================================================*/
//=========| setup |============================================================*/
void setup() {
  long error;


  M5.begin();
  //serial communiction
  Serial.begin(baudRate);      // open the serial port
  while (!Serial) delay(100);  // wait for native usb
  Serial.println("-----!StartingUp!------");
  

  //Start I2C
  Serial.println("-Start: I2C");
  M5.lcd.println("-Start: I2C");

  if (!GPIO_Ports_Instanz.begin_I2C()) {
    Serial.println("Error.I2C");
    M5.lcd.println("Error.I2C");
    while (1)
      ;
  }



  //Pinconfiguration :
  Serial.println("-I2C_ Set Input/Output Pins");
  M5.lcd.println("-I2C_ Set Input/Output Pins ");

  GPIO_Ports_Instanz.pinMode(Mright_Pull_Pin, OUTPUT);         //	Pull+ Blue Motor Left
  GPIO_Ports_Instanz.pinMode(Mright_Dir_Pin, OUTPUT);          //	Dir+ White Motor Left
  GPIO_Ports_Instanz.pinMode(Mright_En_Pin, OUTPUT);           //	En + BrownBlack Motor Left&Right
  GPIO_Ports_Instanz.pinMode(Mright_Alarm_Pin, INPUT_PULLUP);  //	Alarm+ Whiteblack Motor Left
  GPIO_Ports_Instanz.pinMode(Mright_Ped_Pin, INPUT_PULLUP);    //	Ped+ GreenBlack Motor Left
  GPIO_Ports_Instanz.pinMode(Limit_Switch_Pin, INPUT_PULLUP);  //	Reed / Push Sensor
  GPIO_Ports_Instanz.pinMode(Mvertical_ON_Pin, OUTPUT);        //	Vertical Down
  GPIO_Ports_Instanz.pinMode(Mvertical_DIR_Pin, OUTPUT);       //	Vertical Up
  GPIO_Ports_Instanz.pinMode(Clamp_Servo_Pin, OUTPUT);         //	Clamp Orange Servo
  GPIO_Ports_Instanz.pinMode(End_Button2_Pin, INPUT_PULLUP);   //	End_Button 2 left
  GPIO_Ports_Instanz.pinMode(End_Button1_Pin, INPUT_PULLUP);   //	End_Button 1 right
  GPIO_Ports_Instanz.pinMode(Mleft_Ped_Pin, INPUT_PULLUP);     //	Ped+ GreenBlack Motor Left
  GPIO_Ports_Instanz.pinMode(Mleft_Alarm_Pin, INPUT_PULLUP);   //	Alarm+ Whiteblack Motor Left
  GPIO_Ports_Instanz.pinMode(Mleft_En_Pin, OUTPUT);            //	En + BrownBlack Motor Left&Right
  GPIO_Ports_Instanz.pinMode(Mleft_Dir_Pin, OUTPUT);           //	Dir+ White Motor Left
  GPIO_Ports_Instanz.pinMode(Mleft_Pull_Pin, OUTPUT);          //	Pull+ Blue Motor Left



  Serial.println("-I2C: Turn on LED 15");
  M5.lcd.println("-I2C: Turn on LED 15");
  GPIO_Ports_Instanz.digitalWrite(Clamp_Servo_Pin, LOW);

  Serial.println("-I2C: wait 1s");
  M5.lcd.println("-I2C: wait 1s");
  delay(1000);
  Serial.println("-I2C: Turn off LED 15");
  M5.lcd.println("-I2C: Turn off LED 15");
  GPIO_Ports_Instanz.digitalWrite(Clamp_Servo_Pin, HIGH);



  Serial.println("-I2C - Succeed");
  M5.lcd.println("I2C - Succeed");
  Serial.println("-I2C - add PWM Port");
  M5.lcd.println("I2C - add PWM Port");
//start PWM board
    pwm_Ports_Instanz.begin();

    pwm_Ports_Instanz.setOscillatorFrequency(27000000);
    pwm_Ports_Instanz.setPWMFreq(SERVO_FREQ); 

  Serial.println("-Start: I2C - Succeed");
  M5.lcd.println("-Start: I2C - Succeed");

  //Start Wifi

  Serial.println("-Start: Wifi");
  M5.lcd.println("-Start: Wifi");
  Serial.println("-Connect: WiFi...");
  M5.lcd.print("Waiting connect to WiFi...");

  wiFiMulti.addAP(WLAN_SSID, WLAN_PASSWD);
  long sum = 0;

  while (wiFiMulti.run() != WL_CONNECTED) {
    delay(500);
    Serial.print(".");
    M5.lcd.print(".");
    sum += 1;
    if (sum == 8) {
      Serial.println("!Connect: Failed!");
      M5.lcd.print("!Connect: Failed!");
      wiFiMulti.addAP(WLAN_SSID, WLAN_PASSWD);
    }
  }

  Serial.println("");
  Serial.println("-Connect: Wifi -Succeed");
  Serial.print("-Show: IP address: ");
  Serial.println(WiFi.localIP());  //The serial port outputs the IP address of the M5Core2.
  Serial.print("-Show: RSSI: ");
  Serial.println(WiFi.RSSI());
    Serial.print("-Show: GATEWAY: ");
  Serial.println(WiFi.gatewayIP());
   Serial.println(WiFi.status());




  M5.lcd.println("-Connect: Wifi -Succeed");
  M5.lcd.print("-Show: IP address: ");
  M5.lcd.println(WiFi.localIP());  //The serial port outputs the IP address of the M5Core2.
  M5.lcd.print("-Show: RSSI: ");
  M5.lcd.println(WiFi.RSSI());  //Output signal strength

//Get Time

configTime(gmtOffset_sec, daylightOffset_sec, ntpServer); //init and get the time
getLocalTime(&timeinfo);
  Serial.print("-Time: ");
    Serial.print(&timeinfo);
  M5.lcd.print("-Time: ");
      M5.lcd.print(&timeinfo);



  Serial.print("-Start: Timer ");
  M5.lcd.print("-Start: Timer ");
  //start timer
  Timer_Start_01 = micros();
  Timer_Start_02 = millis();

  unsigned char i;
  Serial.println("-Start: -Succeed ");
  M5.lcd.println("-Start: -Succeed ");

  //set Pin Mode

  //StartModBus Server
  Serial.print("-Start: ModBus Server ");
  M5.lcd.print("-Start: ModBus Server ");


  mb.server();
  mb.addHreg(BEFEHL_HREG, 0, 1);
  mb.addHreg(X_HREG, 0, 1);
  mb.addHreg(Y_HREG, 0, 1);
  mb.addHreg(Z_HREG, 0, 1);
  mb.addHreg(F_HREG, 0, 1);
  mb.addHreg(STATUS_HREG, 0, 1);
  mb.onSetHreg(BEFEHL_HREG, CBneuerBefehl);
  mb.onSetHreg(X_HREG, CBneuerParameterX);
  mb.onSetHreg(Y_HREG, CBneuerParameterY);
  mb.onSetHreg(Z_HREG, CBneuerParameterZ);
  mb.onSetHreg(F_HREG, CBneuerParameterF);




  Serial.println("!StartUp Complete!");

  delay(1000);
  M5.Lcd.fillScreen(BLACK);
  M5.Lcd.setCursor(0, 0);
}

//=========| Hauptprogramm    |=================================================*/
void loop() {
  unsigned int cycleCounter = 0;
  unsigned int state = 1;

 //  int sum = 0;

  while (1) {
    state = programSelector;
    M5.update();

    if (cycleCounter > 15) {
      
      M5.Lcd.setCursor(0, 0);
      cycleCounter = 0;

checkWiFiConnection();
    
    }
    cycleCounter++;
     mb.task();

    switch (state) {
      case 1: state = Standby(); break;  //Standby

      case 2: state = Receive(); break;  //receive new Coordinates

      case 3: state = Draw(); break;  //Draw according to the new command

      case 4: state = WrongCommand(); break;  //Received a Wrong Command

      case 5: state = Error(); break;  //Test Modus, Teil 3 (Leistungsmessung mit Last)

      case 6: state = Init(); break;  //Test Modus, Teil 4 (Überprüfung und Anpassung der Daten)

      case 7: state = Calibrate(); break;  //Test Modus, Teil 4 (Überprüfung und Anpassung der Daten)
    }
    programSelector = state;
  }
}




//==============================================================================

//interupt service routinen:
/*---| starte Interrupt Routinen |-----
  attachInterrupt( 3, check_S3DModul1, CHANGE);        //wenn sich Pin  3, Schalter S3D auf dem Modul 1 ändert, wird die ISR ausgeführt
  attachInterrupt( 6, check_S4DModul2, CHANGE);        //wenn sich Pin  6, Schalter S4D auf dem Modul 2 ändert, wird die ISR ausgeführt
  attachInterrupt( 9, check_S5DModul3, CHANGE);        //wenn sich Pin  9, Schalter S5D auf dem Modul 3 ändert, wird die ISR ausgeführt
  attachInterrupt(12, check_S6DModul4, CHANGE);        //wenn sich Pin 12, Schalter S6D auf dem Modul 4 ändert, wird die ISR ausgeführt
  attachInterrupt(24, check_AttachedModul1, CHANGE);   //24,
  attachInterrupt(27, check_AttachedModul2, CHANGE);   //27,
  attachInterrupt(30, check_AttachedModul3, CHANGE);   //30,
  attachInterrupt(33, check_AttachedModul4, CHANGE);   //33
*/
