ElTschonni/DROBOT-alpha/(commit log)

2022-07-09 Add files via upload
    New changes.
    Work on Robot Class,
    Add MCP23017 variables.
    fix some issues with Modbus
    [LibraryDROBOT.h]
2022-07-16 instance of I2C expander works in Robot Library
2022-07-16 Motor Controll
2022-07-16 Motor Test
2022-07-16 Motor Test (Not Turning)
2022-07-17 Motor is working.
2022-07-23 Movment Motor Left Ok
2022-07-26 Kinematic Implementation
2022-07-27 Kinematic working, Motor 2 not Working
    [DROBOT.h]
2022-08-22 CLAMP is working
2022-08-27 ModBUs done, Clamp Done, HMI Done, Offset pending
